UdayanSinha/Home_Automation_System/README.md

# Home_Automation_System
A prototype IoT-friendly home automation system. Built to be scalable and efficient. Some source files are missing in the repository. Feel free to contact for any doubts &amp; queries.
