UdayanSinha/Home_Automation_System/Report.pdf

# HOME AUTOMATION SYSTEM

### A Graduate Project Report submitted to Manipal University in partial fulfilment of the requirement for the award of the degree of

## BACHELOR OF TECHNOLOGY

In

## Instrumentation and Control Engineering

### Submitted by

## Udayan Prabir Sinha

## Pranay Raj Singh

### Under the guidance of

Mr. Anjan Gudigar

Assistant Professor (Sr. Scale) Department of Instrumentation and Control Engineering

DEPARTMENT OF INSTRUMENTATION AND CONTROL ENGINEERING

## MANIPAL INSTITUTE OF TECHNOLOGY

(A Constituent College of Manipal University) MANIPAL – 576104, KARNATAKA, INDIA

May 2015

DEPARTMENT OF INSTRUMENTATON AND CONTROL ENGINEERING

## MANIPAL INSTITUTE OF TECHNOLOGY

(A Constituent College of Manipal University) MANIPAL – 576 104 (KARNATAKA), INDIA

### Manipal 11th May, 2015

## CERTIFICATE

This is to certify that the project titled HOME AUTOMATON SYSTEM is a record

of the bonafide work done by UDAYAN PRABIR SINHA (Reg. No. 110921560) and

PRANAY RAJ SINGH (Reg. No. 110921278) submitted in partial fulfilment of the

requirements for the award of the Degree of Bachelor of Technology (B.Tech) in

INSTRUMENTATION AND CONTROL ENGINEERING of Manipal Institute of

Technology Manipal, Karnataka, (A Constituent College of Manipal University), during

the academic year 2014-15.

Mr. Anjan Gudigar

### Assistant Prof. (Sr. Scale), I & CE M.I.T, MANIPAL

Prof. Dr. Dayananda Nayak
HOD, I & CE.

### M.I.T, MANIPAL

## ACKNOWLEDGMENT

We would like to take this opportunity to thank everyone who directly/indirectly helped us with this project.

We owe our deepest gratitude to my guide, Mr. Anjan Gudigar (Assistant Professor, Sr. Scale) whose encouragement, guidance, expertise and support from the start to the finish enabled us to develop an understanding of the field and finally implement this project.

We are indebted to many of our classmates to support us all the way with the project. We would like to show our gratitude to all the lab assistants and faculty members of the Department of Instrumentation & Control Engineering for providing their valuable experience in our time of need.

Lastly, we offer our regards and blessings to all of those who supported us in any respect during the completion of the project.

## ABSTRACT

The IoT (Internet of Things) is the interconnection of uniquely identifiable embedded computing devices within the existing Internet infrastructure. With major technology giants touting IoT as the next technological revolution in embedded computing, it must be realized that an efficient and reliable home automation system will serve as the backbone of the IoT-enabled world in the consumer domain.

A prototype of a basic and functional home automation system which supports IoT integration is designed and implemented. Due to the modular nature of the design, the whole system was easily divided into small modules, each of which could be designed, tested and debugged independently before integrating them into one complete, fully-functional system. The system was divided broadly in 4 parts as explained in chapter-3: Design of the MCU-based modules, design of the remote controller, design of the central module and final integration and test-run.

A number of glitches/bugs/shortcomings related to power consumption, faulty functionality and some inherent shortcomings of the platform being used for implementation were observed in action during the final integration and testing. The reasons for the occurrence of those glitches and the corrective measures taken for rectifying them have been described.

In the end, a functional home automation system is successfully designed and implemented. Various areas of future improvement in the design are pointed out in chapter-5. A variety of hardware components (PIC18F4550 MCU, Arduino, Raspberry Pi, nRF24L01+ 2.4GHz RF communications module) and software packages (MPLAB-X IDE for PIC MCUs, Python & associated libraries, Arduino IDE, EAGLE for creating schematics, Lucid Chart for creating flowcharts) were used to design the system and the supporting documentation.

## LIST OF TABLES

Table No | Table Title | Page No
3.1 | Operating modes of an nRF24L01+ module | 8

## LIST OF FIGURES

Figure No | Figure Title | Page No
3.1 | Block diagram of the system | 5
3.2 | PIC18F4550 pin diagram | 6
3.3 | nRF24L01+ module | 7
3.4 | Pin diagram of an nRF24L01+ module | 7
3.5 | Radio control state diagram of nRF24L01+ module | 8
3.6 | Block diagram of the relay module | 9
3.7 | Flowchart of the relay module program | 10
3.8 | Circuit schematic of the relay module | 11
3.9 | Hitachi HD44780 controlled 16x2 alphanumeric LCD module pin diagram | 12
3.10 | LM35 temperature sensor pin diagram | 12
3.11 | Flowchart of the display module program | 13
3.12 | Circuit schematic of the display module | 14
3.13 | Flowchart of the password authentication sub-program | 16
3.14 | Flowchart of the password change control sub-program | 17
3.15 | Circuit schematic of the door control module | 18
3.16 | Raspberry Pi Model B+ | 19
3.17 | Arduino Uno | 20
3.18 | Flow of data on the central module | 20
3.19 | Flowchart of the central module program | 21
3.20 | Arduino Mega 2560 | 22
3.21 | Flow of data on the remote controller | 22
3.22 | Flowchart of the remote controller program | 23
3.23 | 7805 pin diagram | 24
3.24 | AMS1117 LDO voltage regulator | 24

## CONTENTS

| Page No
Acknowledgement | | i
Abstract | | ii
List Of Figures | | iii
List Of Tables | | vi
Chapter 1 | INTRODUCTION | 1
| 1.1 | Need For The Project | 1
| 1.2 | Objective | 2
| 1.3 | Project Schedule | 2
| 1.4 | Organization Of Report | 2
Chapter 2 | BACKGROUND THEORY | 3
Chapter 3 | METHODOLOGY | 4
| 3.1 | Design Of The Microcontroller (MCU) Based Modules | 5
| | 3.1.1 | Wireless Module Interfacing | 6
| | 3.1.2 | Relay Module | 9
| | 3.1.3 | Display Module | 12
| | 3.1.4 | Keypad-Based Door Control Module | 15
| 3.2 | Design Of The Central Module | | 19
| 3.3 | Design Of The Remote Controller | | 22
| 3.4 | Power Supply Design | | 24
Chapter 4 | RESULT ANALYSIS | 25
Chapter 5 | CONCLUSION AND FUTURE SCOPE OF WORK | 26
REFERENCES | 27
ANNEXURE | 28
PROJECT DETAILS | 38

1

### CHAPTER 1 INTRODUCTION

The IoT (Internet of Things) is the interconnection of uniquely identifiable embedded computing devices within the existing Internet infrastructure. Typically IoT is expected to offer advanced connectivity of devices, systems and services that go beyond standard M2M (machine-to-machine) communications [1]. It is expected to usher in automation in nearly all fields and allow for advanced applications like Smart Grid [1]. A home automation system has been envisioned to be the central hub of IoT-enabled devices in the consumer domain. Hence, it is necessary that a reliable, efficient and smart home automation system be designed to allow for easy integration of such devices.

### 1.1 NEED FOR THE PROJECT

With major technology giants touting IoT as the next technological revolution in embedded computing, it must be realized that an efficient and reliable home automation system will serve as the backbone of the IoT-enabled world in the consumer domain [1]. A home automation system in an IoT-enabled world will be connected to for example:

- Medical devices such as blood glucose monitors and pace makers which would send regular reports to the doctor via the Internet connection of the home automation system. This will allow for potentially early diagnosis of diseases and better health monitoring [3].
- Automobiles, the on-board car computer will monitor data from various sensors & alert the end-user in situations like when maintenance is required or tire pressure is low or it needs to be refueled.
- Home security systems to automatically alert the emergency services in situations like fire, break-in, etc. [2].
- IoT-enabled home appliances; for example a coffee-maker which automatically brews up coffee for the end-user in the morning when he wakes up & in the evening when he is about to return from work or a smart refrigerator which uses computer vision to monitor food health & alert the user of rotting food [2].
- Wearable computers like smart watches.
- Smart energy meters to intelligently regulate power to the house & ensure that monthly power consumption does not cross a fixed threshold [2].

2

The nature of IoT warrants a modular and (depending on the application) possibly decentralized design of the system.

### 1.2 OBJECTIVE

To design and implement a basic and functional home automation system which allows easy integration of IoT-enabled devices.

### 1.3 PROJECT SCHEDULE

- January 2015
- Design of the system and finalization of its specifications.
- Selection of components.
- February 2015
- Design of microcontroller based modules.
- March 2015
- Design of the remote controller.
- Design of the central module.
- April 2015
- Integration of the module into 1 complete system.
- Complete system test-run and optimization.
- May 2015
- Documentation.

### 1.4 ORGANIZATION OF REPORT

- Chapter 1: Brief introduction of the project and motivation. Project objectives and schedule are also included
- Chapter 2: Survey of relevant literature and conclusions drawn from it.
- Chapter 3: Project methodology, program flowcharts and working
- Chapter 4: Result analysis. Analysis of shortcomings detected and corrective measures taken.
- Chapter 5: Future scope of the project discussed.

3

### CHAPTER 2 BACKGROUND THEORY

Mentioned below are some of the relevant literature which that were reviewed and the topics which were found to be relevant to the project in that literature:

- Richard Harper [2], talks about the predictions of leading electronics and consumer companies such as, in the future we may never again have to worry about forgetting to switch the lights off, or locking the front door when we leave our home. Even mundane chores such as visiting the local supermarket to stock up your fridge will become a thing of the past, as the Smart Homes of the future will be able to decide what is needed and order them for us. This book looks at the designs and technologies behind these new innovations, along with their time-saving, environmental and security benefits, amongst others. Despite these clear advantages however, Smart Homes have so far failed to reach the levels of success originally anticipated, thereby forcing designers to further examine the roles and practicalities of these new technologies. Through the use of detailed case studies from such international giants as Orange, Ariston, Philips Electronics and Electrolux, this book clearly demonstrates what will be possible for our domestic settings in the future if we continue to develop the concept of the Smart Home.
- William Mann [3], talks about recent research and technological developments from engineering, computer science, and the rehabilitation sciences, detailing how its applications can promote continuing independence for older persons and those with disabilities. The author has used detailed product descriptions, photographs and illustrations, and case studies, to discuss the influence of cutting-edge technologies on wearable systems, human-computer interactions, assisted vision and hearing, smart wheelchairs, handheld devices and smart phones, visual sensors, home automation, assistive robotic sand in-room monitoring systems. The author examines recent trends in other critical areas, such as basic assistive technologies, driving, transportation and community mobility, home modifications and design, and changing standards of elder care.
- Recently, it is observed that how the Internet of Things (IoT) will deliver a smarter grid to enable more information and connectivity throughout the infrastructure and to homes [1]. The author explains how the IoT, consumers, manufacturers and utility providers will uncover new ways to manage devices and ultimately conserve resources and save money by using smart meters, home gateways, smart plugs and connected appliances. The author

4

discusses, the different approaches being taken worldwide to connect the smart grid. Examples are provided on how Texas Instruments is developing full system solutions by combining hardware (analog and digital) and software to address some of the challenges in building a smarter and more connected smart grid. The author also tells us about the key defining characteristics of an IoT device and the role of a full-fledged home automation system in consumer IoT.

All of the above mentioned literature put forward some important design aspects which must be considered while designing IoT applications:

- Power efficient design.
- Modular and decentralized design.
- Networked design.
- An IoT device does not need to be connected to the Internet directly.

5

### CHAPTER 3 METHODOLOGY

The modular nature of the design allows easy division of the whole system into small modules, each of which can be designed, tested and debugged independently before integrating them into one complete, fully-functional system.

Hence, project design is carried out in the following parts:

- Design of the microcontroller based modules:
- Design of the display module (displays useful information to the user).
- Design of the relay module (use to control flow of power to appliances, lights, fans, etc.).
- Design of the door locking module (used to lock/unlock front door of the house).
- Design of the remote controller (used by the user to control the system):
- Selection of interface (preferably touch-screen) & required hardware.
- Design of software for the interface and transmit input data in a desirable format wirelessly.
- Design of the central module:
- Implement program to fetch weather & time data using an appropriate developer API.
- Use available libraries to process the data and transmit it in desirable format wirelessly.
- Final integration and testing:
- Optimize and integrate the modules into a complete and functional home automation system.

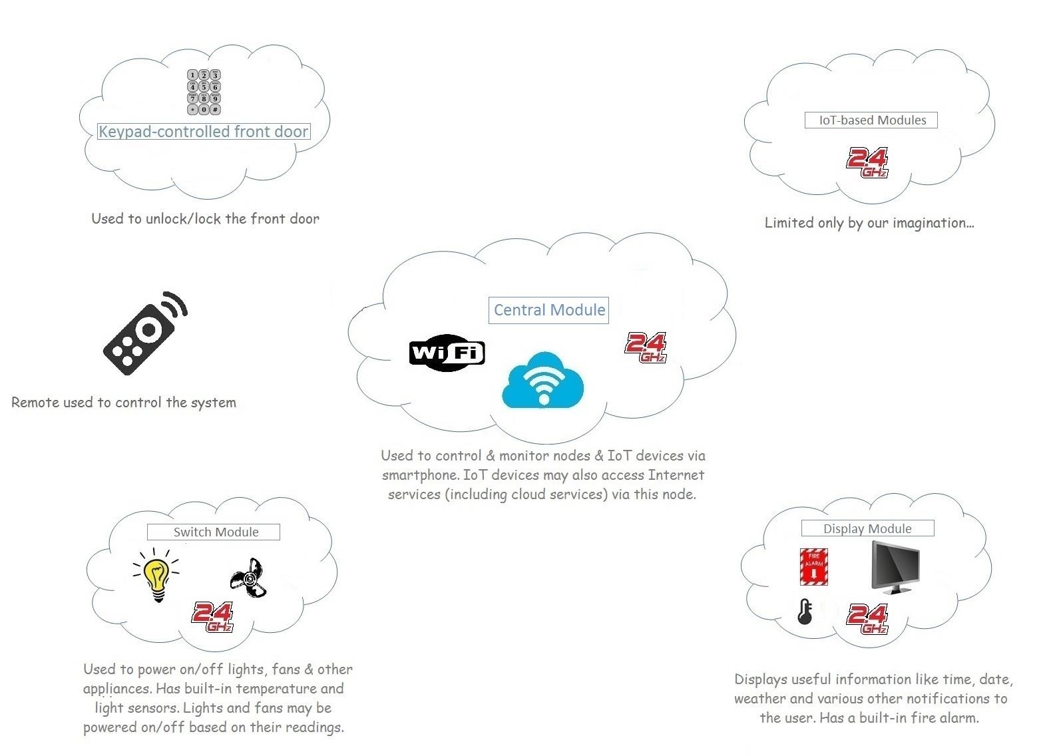
[picture p1: figure]

6

Fig. 3.1 Block diagram of the system

### 3.1 DESIGN OF THE MICROCONTROLLER (MCU) BASED MODULES

All MCU-based modules have been implemented using the PIC18F4550. The PIC18 family of MCUs were selected due to the following reasons:

- Extremely reliable architecture.
- User-friendly IDE (Integrated Development Environment) and professional-grade C-compiler.
- Excellent documentation and programming tools.
- Easily available at lower price (compared to rival manufacturers).
- The rich set of features and peripherals on-board the PIC18F4550 allows plenty of room for further functionality improvement and enhancement.

7

Specifications of the PIC18F4550:

- 8-bit MCU.
- 32kB flash memory.
- 2kB RAM.
- 256 bytes EEPROM.
- Available in a 40 pin DIP (Dual-inline package).
- 12MIPS maximum throughput.

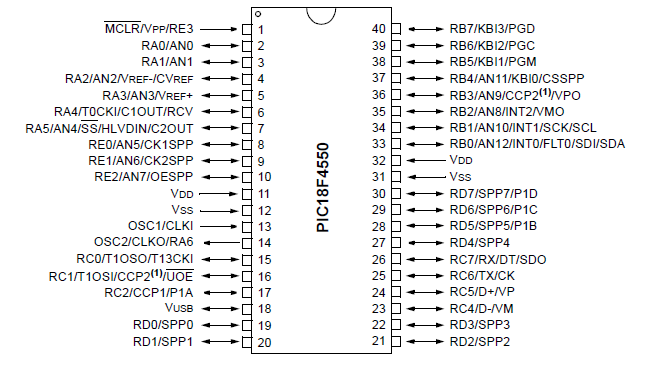
[picture p2: figure]

Fig. 3.2 PIC18F4550 pin diagram

### 3.1.1. Wireless Module Interfacing

While Zigbee is a good choice for this application, it was too expensive. It was decided to use the low cost nRF24L01+ 2.4GHz RF transceivers by Nordic Semiconductors. nRF24L01+ has been specifically designed for power efficient IoT-based applications which require efficient and reliable communication and can be easily interfaced to an MCU.

Basic specifications of the nRF24L01+:

- Communication at 2.4GHz with air data rates of up to 2Mbps.
- SPI interface.
- Maximum data payload of 32 bytes.
- 3.3V logic (5V-tolerant I/O pins).

8

- Interrupt on packet reception and transmission.
- Guaranteed 30m line-of-sight range at 2Mbps air data rate.

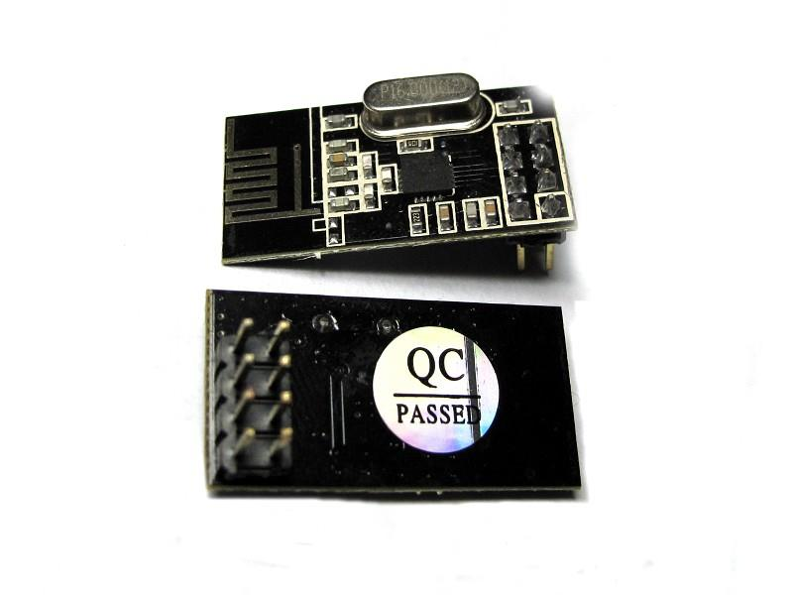
[picture p3: figure]

Fig. 3.3 nRF24L01+ module

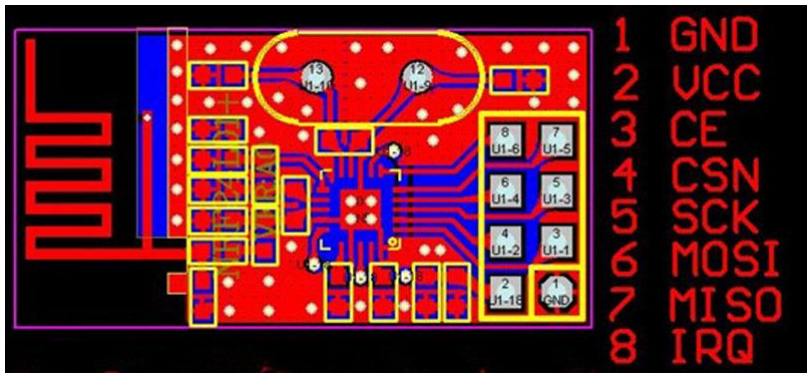
[picture p4: figure]

Fig. 3.4 Pin diagram of an nRF24L01+ module

With plenty of documentation and tutorials available for it, it was easy to get an Arduino and a PIC MCU communicating with each other wirelessly in the tests. In the project, the data rate has been set to 250kbps (slowest) and the payload length to 8 bytes. The SPI bus speed is limited to 312.5 kbps. The module can only transmit or receive data at any given instant (half-duplex communication).

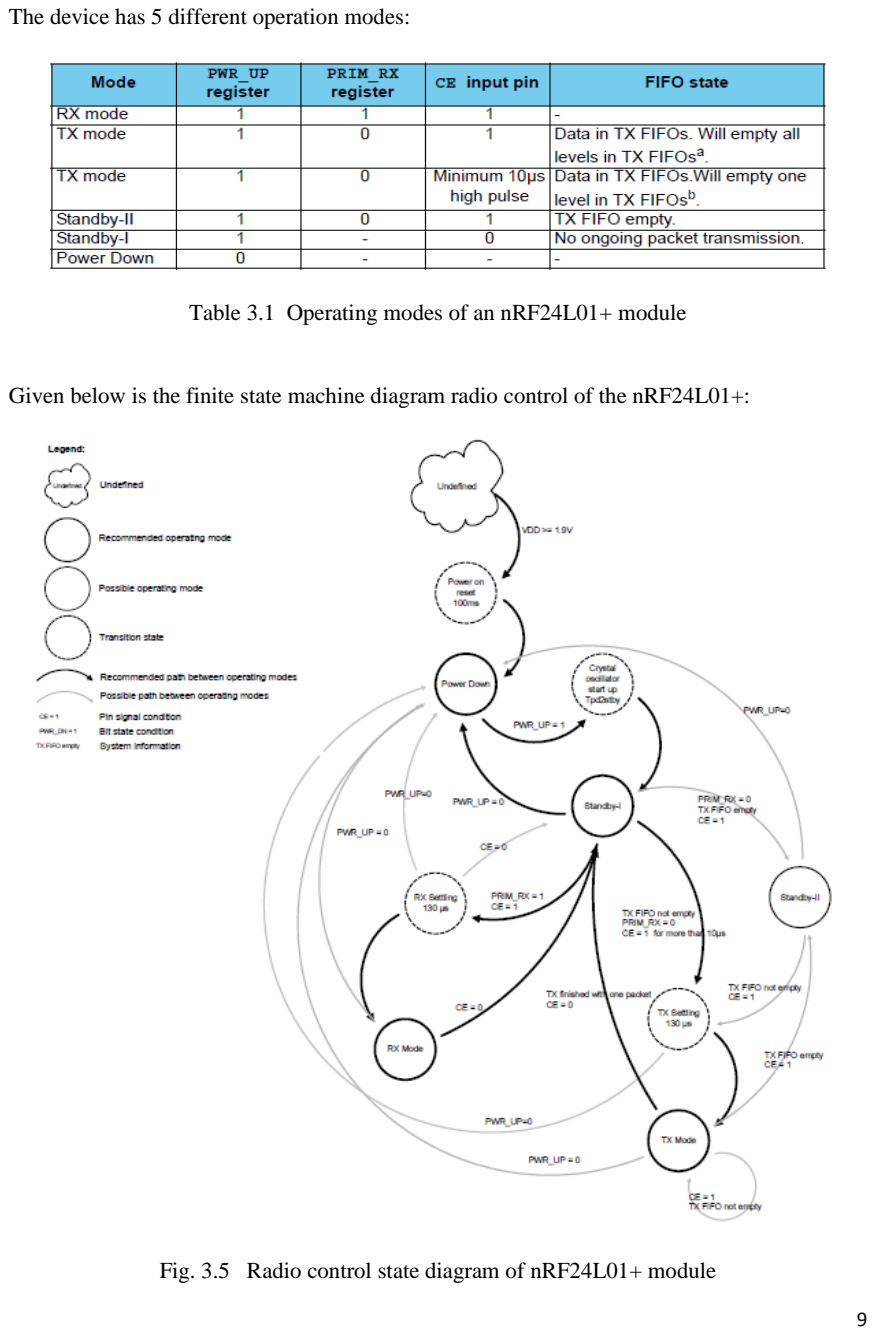
[picture p5: page 16]

9

The device has 5 different operation modes:

Table 3.1 Operating modes of an nRF24L01+ module

Given below is the finite state machine diagram radio control of the nRF24L01+:

Fig. 3.5 Radio control state diagram of nRF24L01+ module

10

### 3.1.2 Relay Module

Relay module is implemented using a PIC18F4550. Testing involved sending control codes via the remote controller and checking for the correct response from the module. All communication took place wirelessly via the nRF24L01+.

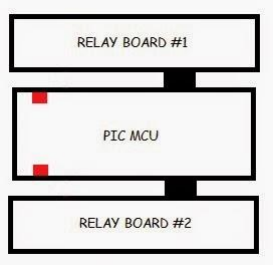
[picture p6: figure]

Fig. 3.6 Block diagram of the relay module

- There are 8 relays on each board (16 relays in total). The end-user may choose to buy 1 or both boards for use in the system. Off-the-shelf relay boards will be used in the design.
- The black connections between the PIC MCU and the relay boards represent control lines for energizing/de-energizing the relays.
- The red dot on the PIC MCU board represents enable lines for each of the board. This is a safety feature.
- Whenever a relay board is connected, the enable line for it is activated. This is detected by the PIC MCU. The ports controlling that relay board can only be used when the enable line is activated.

11

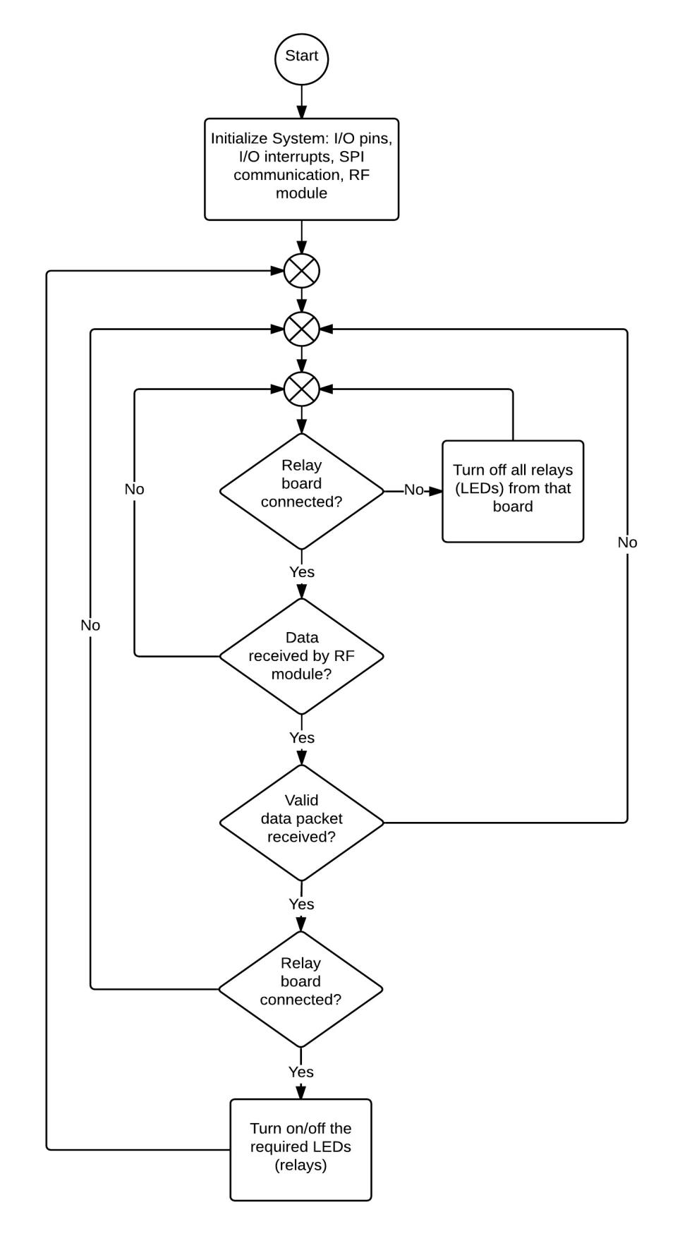
[picture p7: figure]

Fig. 3.7 Flowchart of the relay module program

12

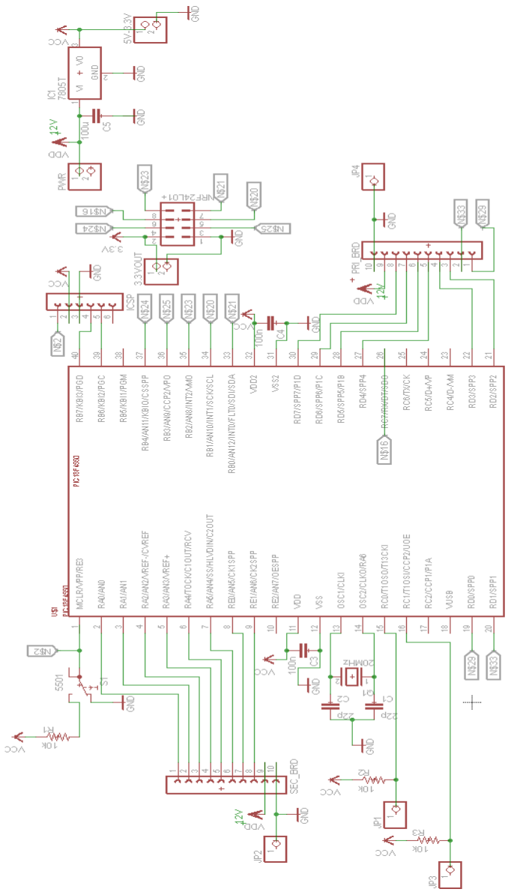
[picture p8: figure]

Fig. 3.8 Circuit schematic of the relay module

13

### 3.1.3 Display Module

The display module has been implemented using the PIC18F4550. There are 2 types of messages which this module will be receiving wirelessly via the nRF24L01+:

- Weather data
- Time & date data

The module toggles between displaying time-date and weather every 10 seconds. This information is displayed on a standard Hitachi HD44780-controlled 16x2 alphanumeric LCD. This LCD is widely used in embedded system projects and hence, it was easy to interface it with the PIC MCU.

An LM35 temperature sensor is also used for sensing the room temperature. An indicator LED (alarm) will light up to indicate the possibility of fire if the temperature exceeds 55°C. Just like the LCD, LM35 is a widely used temperature sensor in embedded system projects and it was easy to interface it with the PIC MCU. It is factory-calibrated directly in °C (10mV/°C linear sensitivity) and can be used to sense temperature ranging from -55°C to 150°C.

Hence there are 2 parts to the program (both running simultaneously):

- Display management: Toggles between displaying time-date and weather.
- Wireless communication: Receives data and sorts it systematically for displaying.

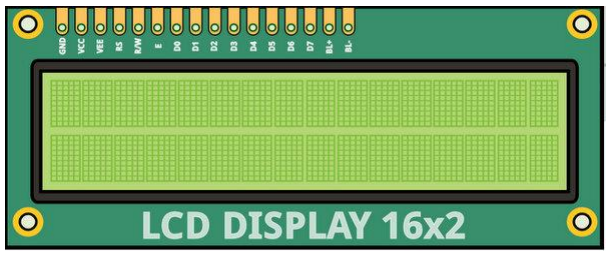
[picture p9: figure]

Fig. 3.9 Hitachi HD44780 controlled 16x2 alphanumeric LCD module pin diagram

Fig. 3.10 LM35 temperature sensor pin diagram

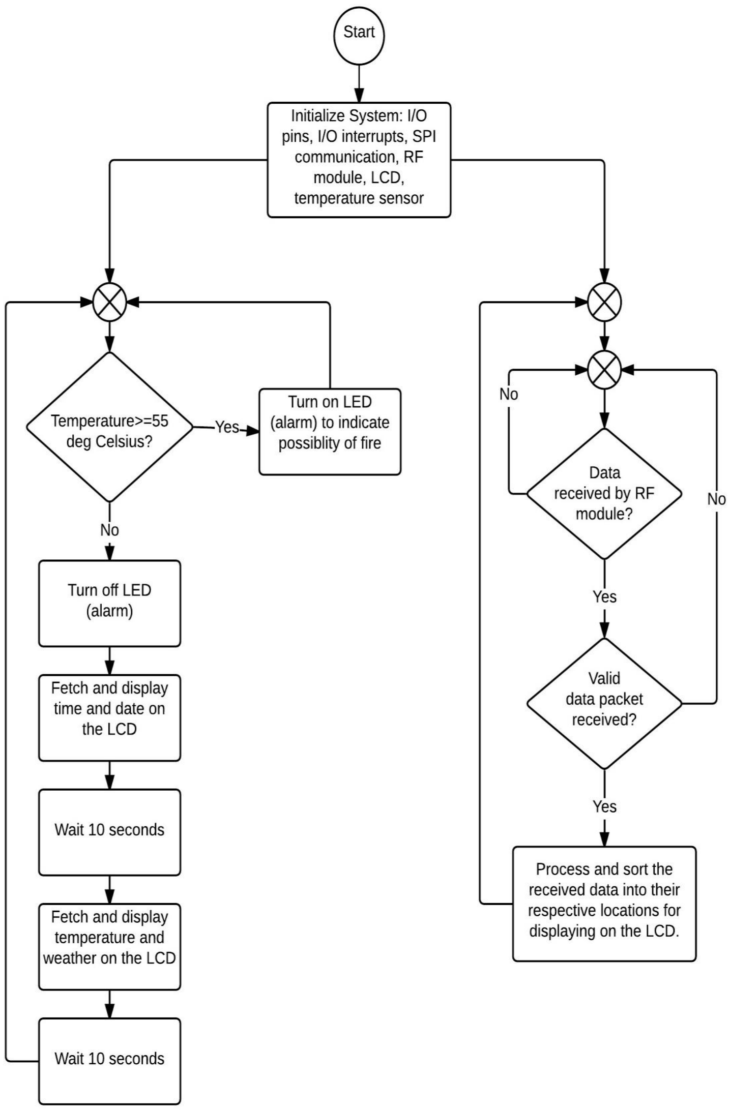
[picture p10: figure]

14

Fig. 3.11 Flowchart of the display module program

15

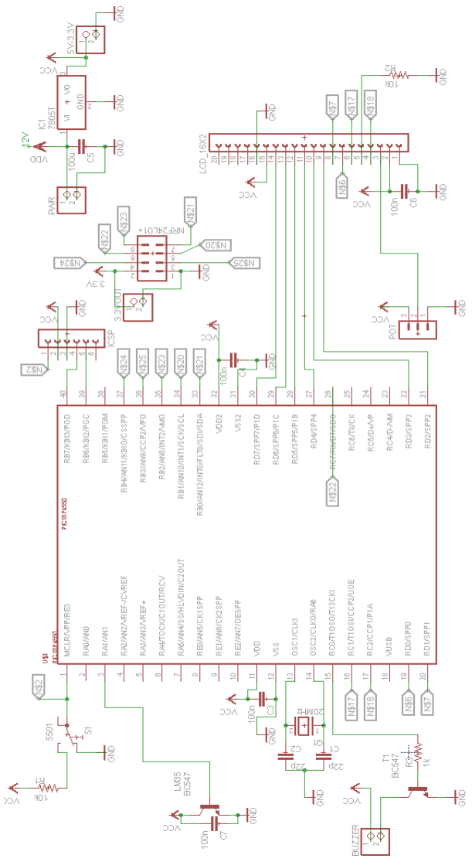
[picture p11: figure]

Fig. 3.12 Circuit schematic of the display module

16

### 3.1.4 Keypad-Based Door Control Module

The door control module has been implemented using a PIC18F4550. This will be the only module in the project which does not have a wireless module (nRF24L01+) attached to it. A standard Hitachi HD44780-controlled 16x2 alphanumeric LCD is used to display messages to and interact with the user. This LCD is widely used in embedded system projects and hence, it was easy to interface it with the PIC MCU.

A standard 4x4 matrix keypad is used to enter the password.

Features of this module:

- Standard Hitachi HD44780 controlled 16x2 alphanumeric LCD displays useful messages to the user.
- 4x4 keypad used to enter passwords.
- A yellow LED used to indicate key press.
- A green LED used to indicate that the door lock actuator is energized.
- Pushbutton used to start/stop password change procedure.
- Password is stored in the internal EEPROM of the PIC MCU.

When a correct password is entered, the actuator is energized for 5 seconds. The user must open the door in this time or he/she would have to enter the password again. Password length has been set to 4 digits (can be easily set to any value up to 256 digits).

For changing the password, the password-change button is pressed. Standard 3-step password-changing procedure is used to change the password:

- Entry of old password
- Entry of new password
- Confirmation of new password

The user can choose to quit the password-changing procedure by pressing the password-change button at any point of time in between if he decides against changing the password.

Hence there are 2 parts to the program, both running simultaneously on the MCU:

- Password authentication: Used for door access control.
- Password change control: Used to change the password used for door access control.

17

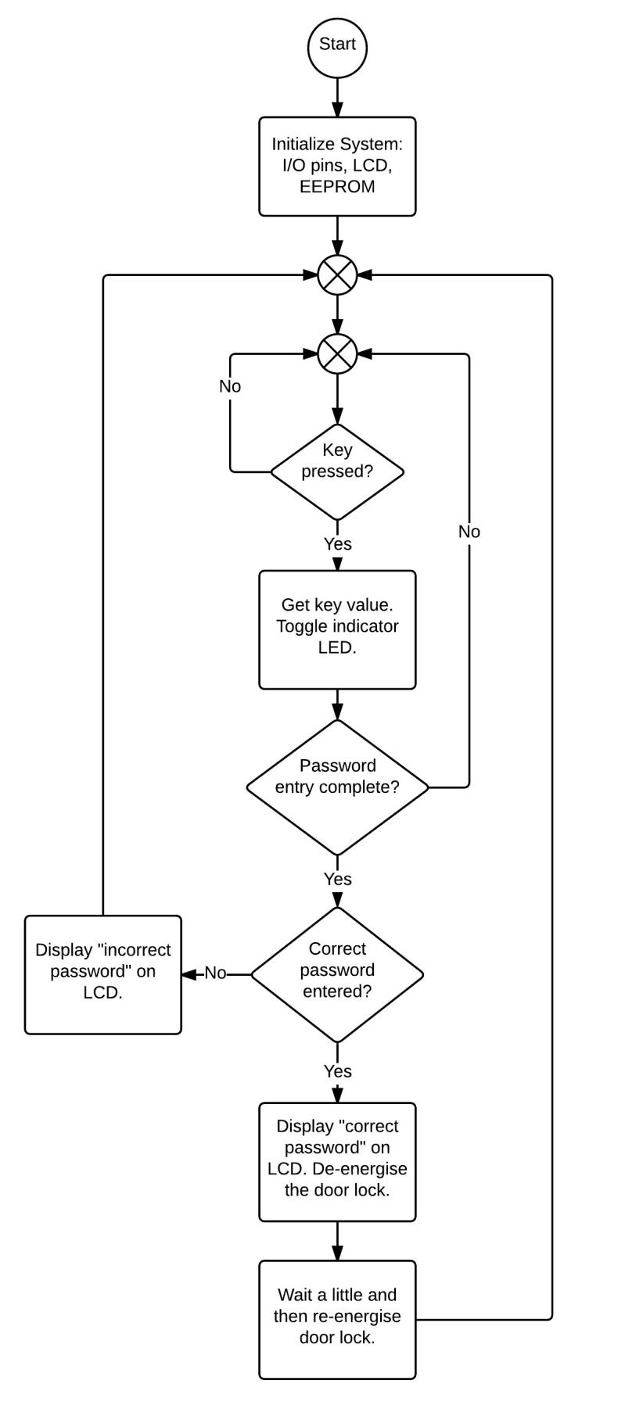
[picture p12: figure]

Fig. 3.13 Flowchart of the password authentication sub-program

18

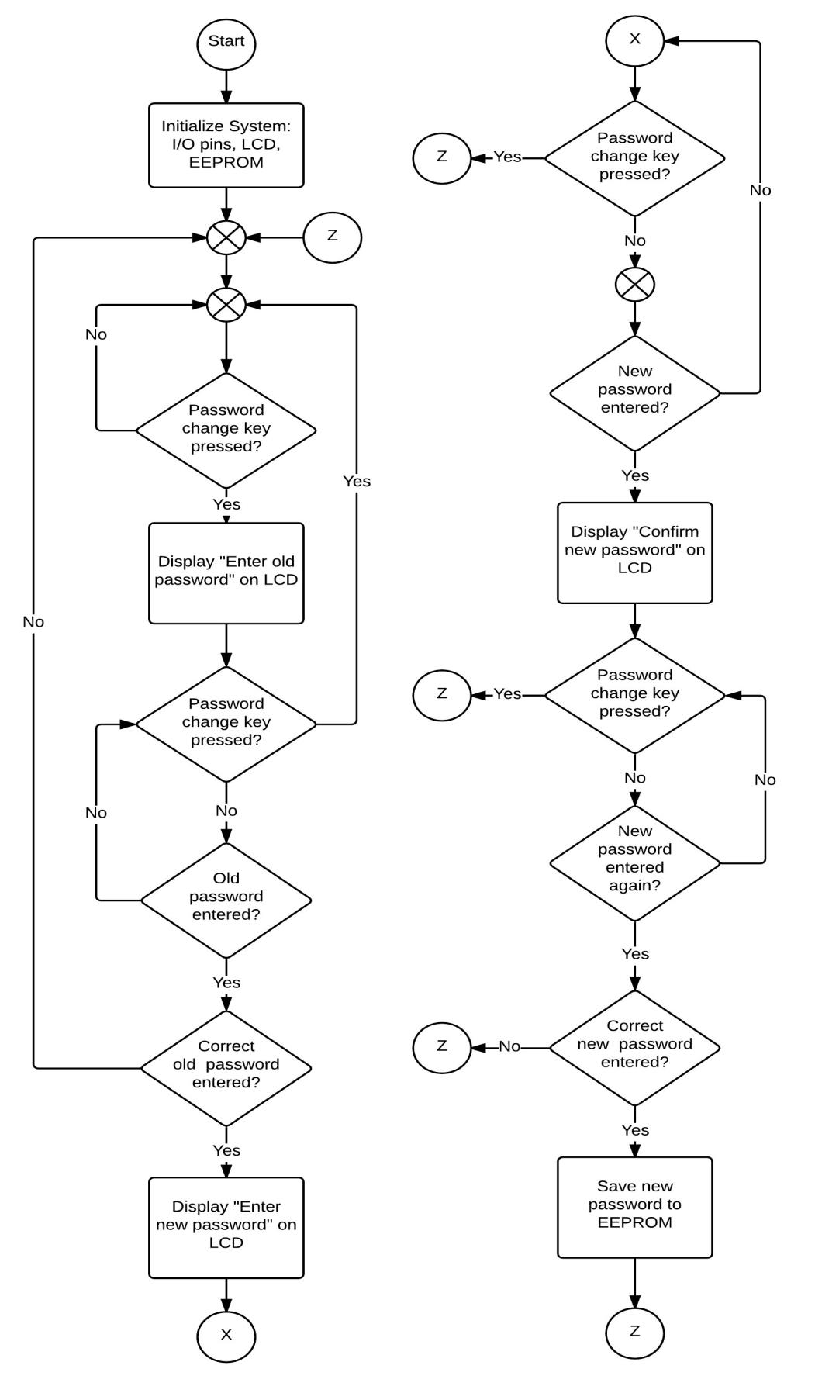
[picture p13: figure]

Fig. 3.14 Flowchart of the password change control sub-program

19

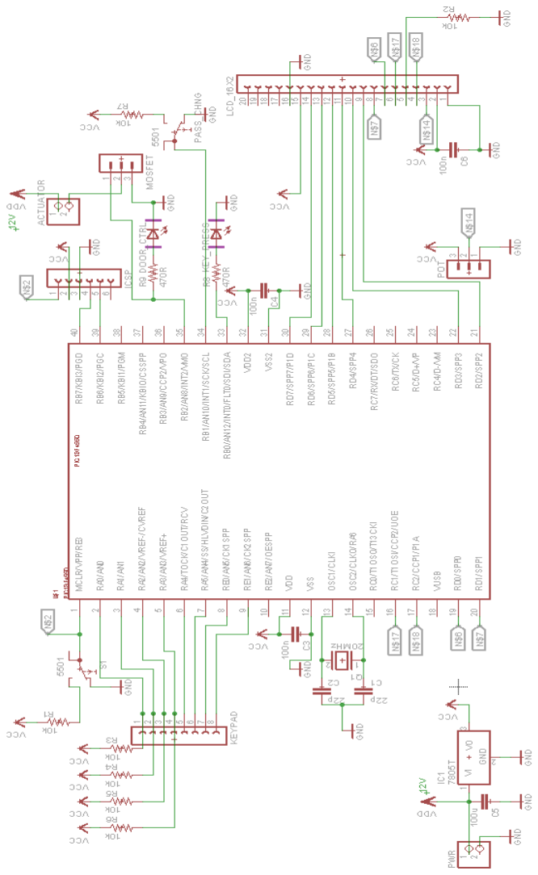
[picture p14: figure]

Fig. 3.15 Circuit schematic of the door control module

20

### 3.2 DESIGN OF THE CENTRAL MODULE

The central module is being implemented using a Raspberry Pi B+ single-board computer (SBC) and an Arduino Uno.

Key specifications of the Raspberry Pi B+:

- Broadcom BCM2835 SoC
- 700MHz ARM11 CPU
- 512MB RAM
- 4 USB 2.0 ports, 1 RJ45 Ethernet port, 1 HDMI port, 1 3.5mm audio jack
- 20x2 pin header

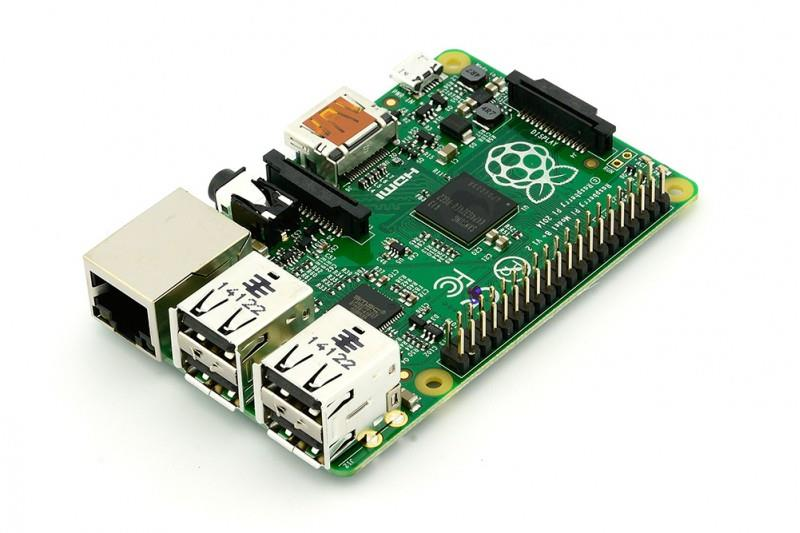
[picture p15: figure]

Fig. 3.16 Raspberry Pi Model B+

The Raspberry Pi is a widely used versatile and powerful Linux-based SBC with extensive documentation and community support. Since Raspbian (the default Linux “distro” for the Raspberry Pi) is Debian Wheezy-based, most of the standard Linux libraries can be used out-of-the-box without any modifications. Use of Python for programming is an additional advantage due to its ease of use.

21

Key specifications of the Arduino Uno:

- ATmega328 8-bit MCU.
- 32kB flash memory.
- 2kB RAM.
- 1kB EEPROM
- Available in a 28-pin DIP.
- 16MIPS maximum throughput.

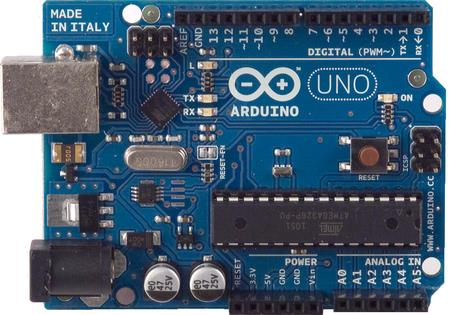
[picture p16: figure]

Fig. 3.17 Arduino Uno

The Arduino Uno is another widely used versatile and powerful open-source MCU development board with extensive community support and documentation.

Weather data is fetched through standard developer APIs from Weather Underground. The data is received in JavaScript format, which is then processed by the Raspberry Pi using standard Python libraries into a structured dictionary for easy access. Date and time are fetched and processed using standard Python libraries as well.

These are sent to the Arduino Uno via UART (Universal Asynchronous Receiver Transmitter). The Arduino then transmits this information wirelessly via nRF24L01+.

Fig. 3.18 Flow of data on the central module

22

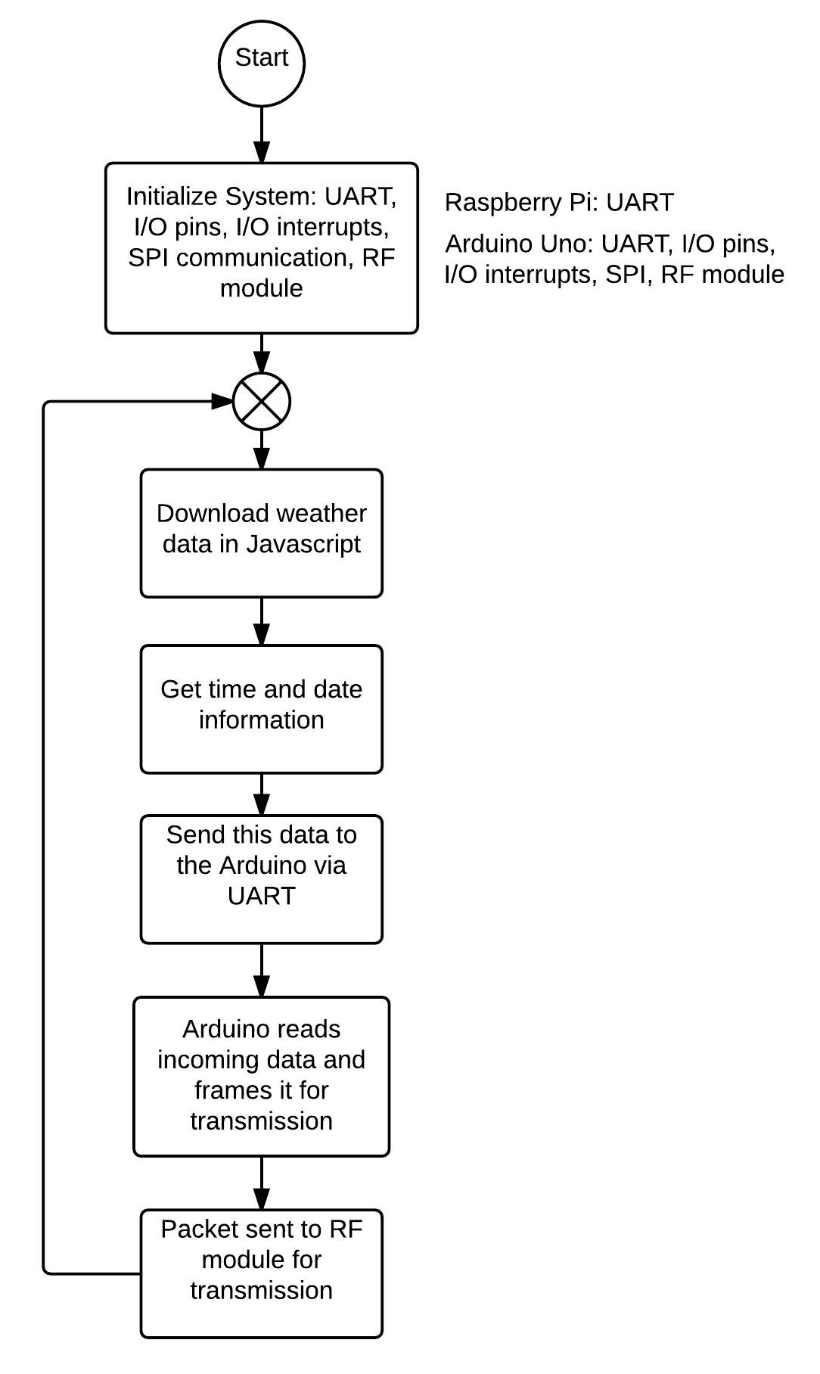
[picture p17: figure]

Fig. 3.19 Flowchart of the central module program

23

### 3.3 DESIGN OF THE REMOTE CONTROLLER

The central module is being implemented using a Raspberry Pi B+ single-board computer (SBC) and an Arduino Mega 2560. An Arduino and a Raspberry Pi was chosen again here mainly due to the large community support and extensive documentation for each of the platforms and their flexibility.

Key specifications of the Arduino Mega 2560:

- ATmega 2560 8-bit MCU.
- 256kB flash memory.
- 8kB RAM.
- 4kB EEPROM
- 54 GPIO (general purpose I/O) pins
- 16MIPS maximum throughput.

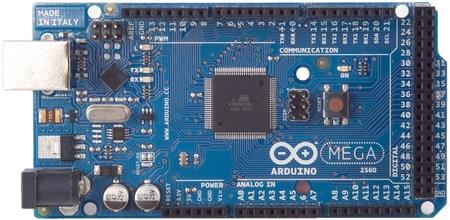
[picture p18: figure]

Fig. 3.20 Arduino Mega 2560

A standard Python GUI developer framework known as TKinter to develop the GUI in Python. The GUI has been designed to be simple as well as maintain functionality and reliability. The GUI has been designed for controlling 1 relay boards for now. It can easily be expanded for controlling more boards if necessary. The GUI is intended for touch-based controllers but can be used through a simple mouse-keyboard interface too.

This Python-based GUI accepts inputs from the user and controls a number of I/O pins accordingly. The Arduino Mega 2560 reads the state of these I/O pins and accordingly sends control signals to the relay module.

Fig. 3.21 Flow of data on the remote controller

24

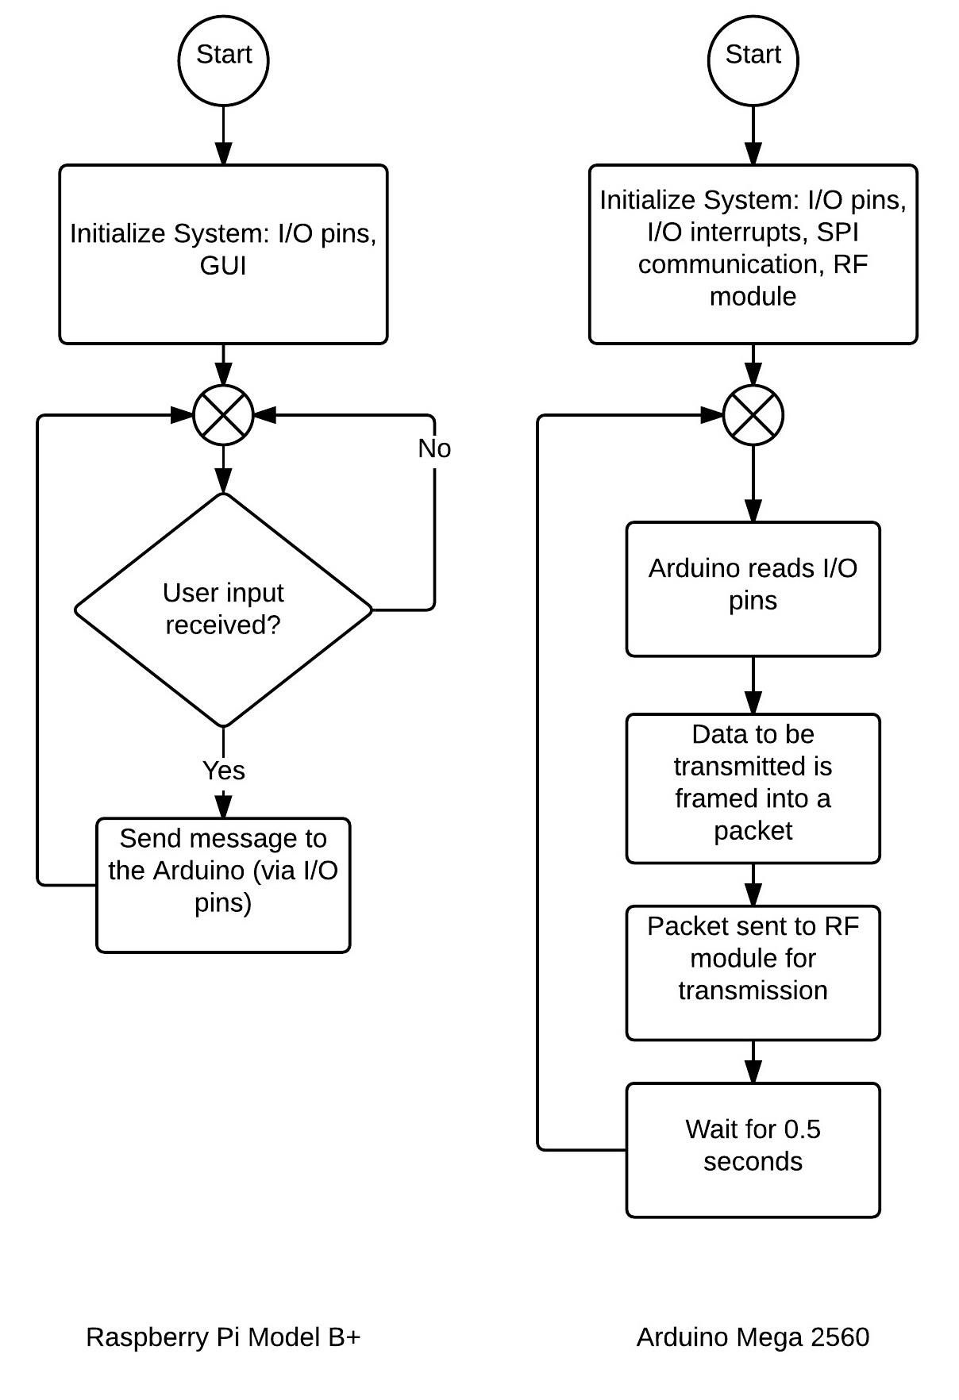
[picture p19: figure]

Fig. 3.22 Flowchart of the remote controller program

25

### 3.4 POWER SUPPLY DESIGN

The system requires 2 separate power rails for operation:

- 5V
- 3.3V (only for the nRF24L01+)

The 5V power rail for the MCU-based modules was designed using a 7805 positive voltage regulator. It is a widely used voltage regulator with maximum output current of up to 500mA (without heat sink) and up to 1A (with heat sink), more than enough to ensure smooth operation of the system.

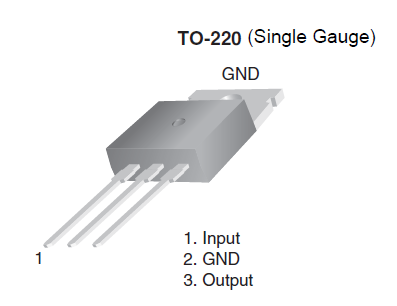
[picture p20: figure]

Fig. 3.23 7805 pin diagram

The 3.3V power rail for the MCU-based modules was designed using an AMS1117 LDO (low drop-out) voltage regulator. 5V output from the 7805 is fed into the AMS1117 to create the 3.3V rail for the nRF24L01+. It can provide output current of up to 1A. Since the IC is available only in SMD (surface-mount device) packages, a breakout PCB was used for implementation as shown below.

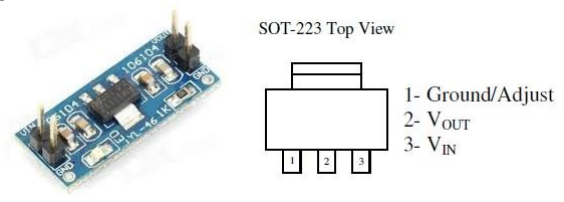
[picture p21: figure]

Fig. 3.24 AMS1117 LDO voltage regulator

The remote controller and the central modules already have 5V and 3.3V power rails built into them.

26

### CHAPTER 4 RESULT ANALYSIS

With all the modules independently designed and tested successfully, they were finally integrated into 1 complete system. The following glitches/bugs/shortcomings where noticed during the final integration and testing:

- A glitch was noticed in the relay module which caused the relays to automatically switch on/off erratically. This was caused due to the program continuously scanning and updates the I/O pin states. This was corrected to only scan/update the I/O pins when it receives a new data packet through the nRF24L01+.
- An additional shortcoming discovered in the prototype was the high consumption of power by the modules (IoT-based applications should be power efficient) as they were fully active even when not doing any significant work. This could not be rectified at this stage without changing the program flow significantly and conducting extensive tests on the performance of the new code. This can, however be corrected in future iterations of the prototype and the features required to achieve this are already present in the processing devices (as discussed in the next chapter).
- A glitch was observed in the Arduino Uno development board which is connected to the display module. The latest revision of the Arduino Uno boot-loader has a bug which sometimes causes the MCU to “hang up” during operation. This will however be rectified in forthcoming versions of the boot-loader. A temporary fix to this problem would be to use another Arduino Mega 2560 instead of an Arduino Uno (the boot-loader for the Arduino Mega 2560 is completely stable) or flashing the ATmega328 on the Arduino Uno with a previous version of the boot-loader.

Rest assured, the system performed as expected during the tests.

27

### CHAPTER 5 CONCLUSION AND FUTURE SCOPE OF WORK

The objective was to design and implement a basic and functional home automation system which allows easy integration of IoT-enabled devices.

A modular approach was employed to design the system (described earlier in detail):

- Design of the microcontroller based modules.
- Design of the remote controller (used by the user to control the system).
- Design of the central module.
- Final integration and testing.

While a basic and functional home automation system was successfully designed, implemented and tested, there is plenty of space for future improvements in the design:

- Increasing power efficiency: Improvement in power consumption by put the modules in sleep mode and using wake-up-on-interrupt feature (available in most MCUs now). This would result in a drastic decline in power consumption. After all, power efficiency is envisioned to be a defining characteristic of most IoT-enabled devices.
- Use of smartphone based remote controllers: Carrying an extra device can tend to be cumbersome and tedious for the end-user. A smartphone-based solution on the other hand is more efficient and handy. Suitable apps can be designed for Android and iOS based devices (since these are the 2 most widely used mobile OS platforms). This would however require that all communication to and from the smartphone occur through the central module as that is the only module connected to the Internet directly (Bluetooth has limited range). Used of a smartphone will also allow easy control of any IoT-enabled devices connected to the system. A whole ecosystem of apps for control of the system and IoT-enabled devices can be created.
- Use of a more aesthetically appealing GUI on the display module: This would however increase the cost of the system as an SBC would be required to support such a GUI.
- Use of camera at the front door: To take a snapshot of the person who is entering the house. This can be used for security by alerting the user to possible break-in. Various other security measures like motion sensors can also be used at other doors and windows.

28

### REFERENCES

1. O. Monnier, A smarter grid with the Internet of Things, SLYB214, Texas Instruments, May 2014.
2. Harper, Richard, Inside the smart home, Springer, ISBN: 1852336889
3. Mann, William, Smart technology for aging, disability and independence: the state of the science, John Wiley & Sons, ISBN: 0471696943

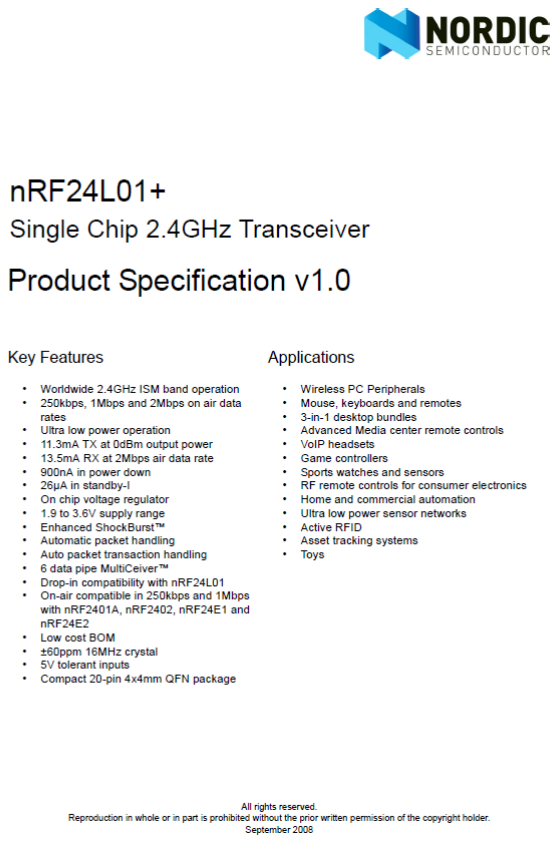
[picture p22: figure]

29

ANNEXURE

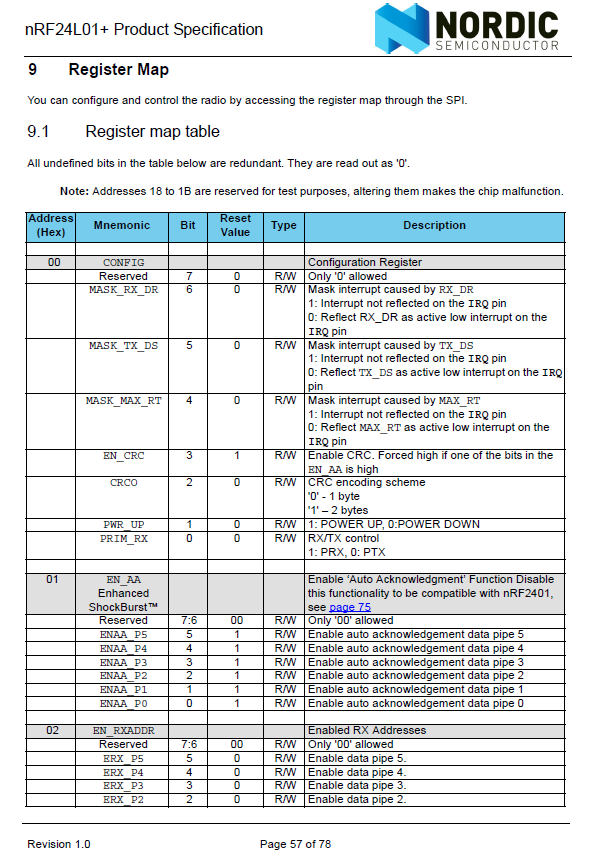
[picture p23: figure]

30

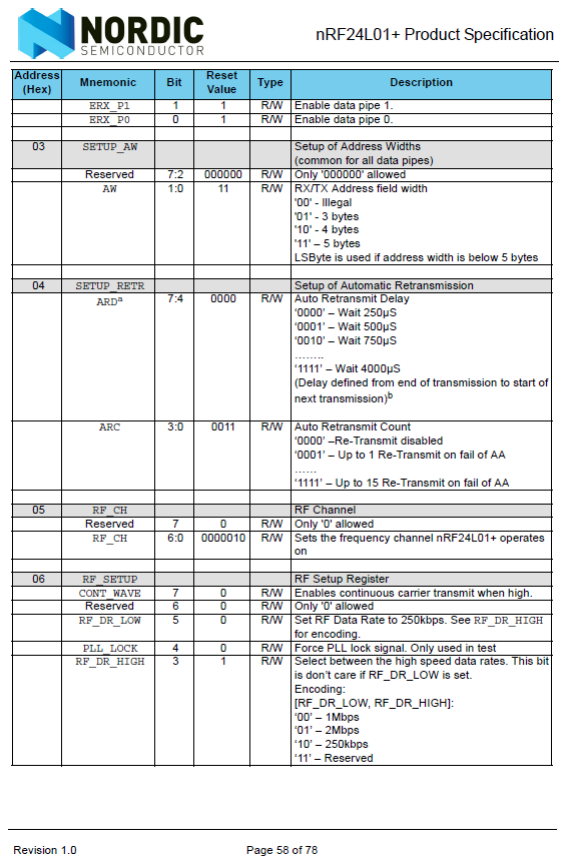
[picture p24: figure]

31

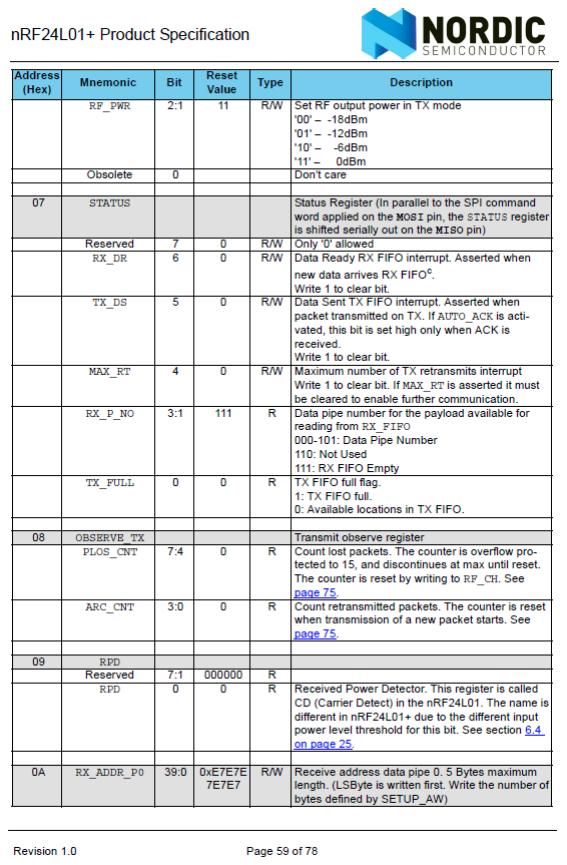
[picture p25: figure]

32

33

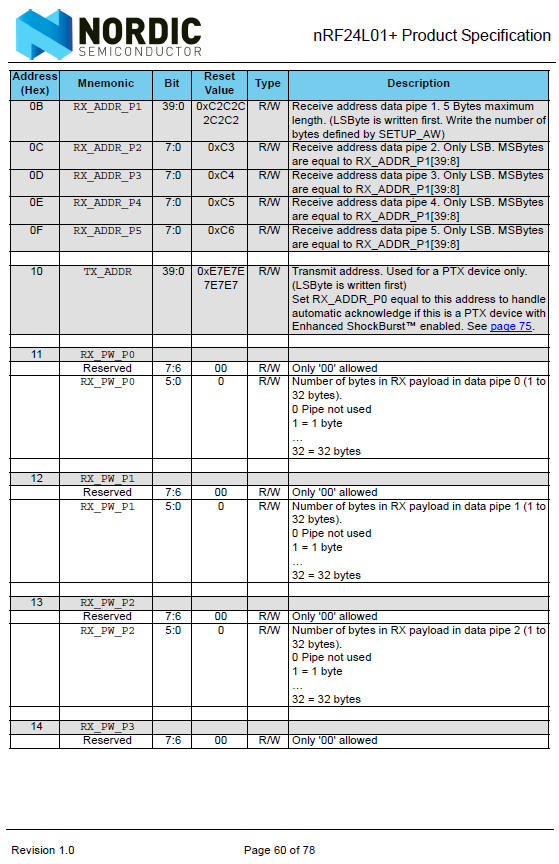
[picture p26: figure]

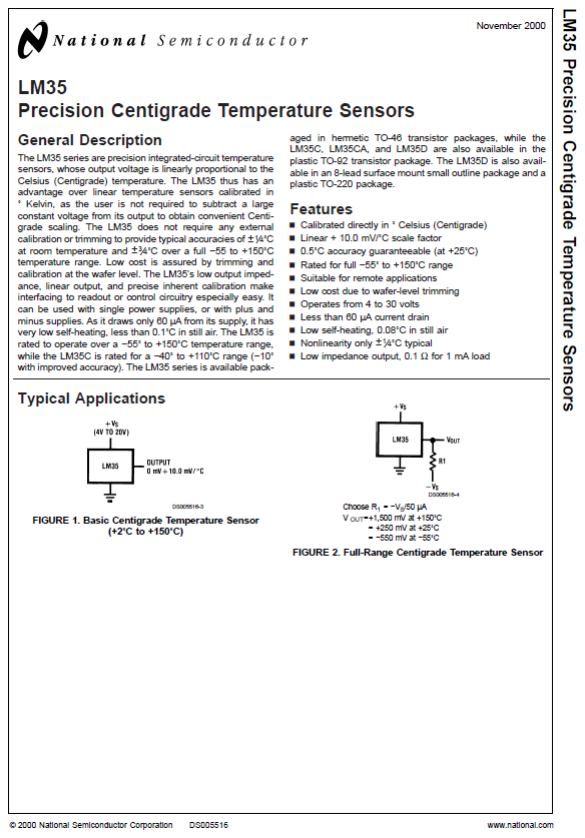
[picture p27: figure]

34

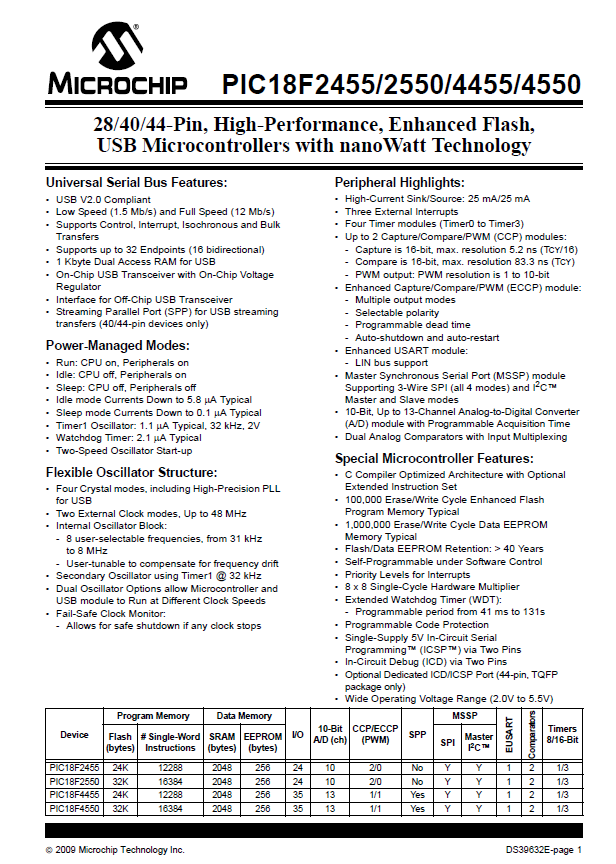
[picture p28: figure]

35

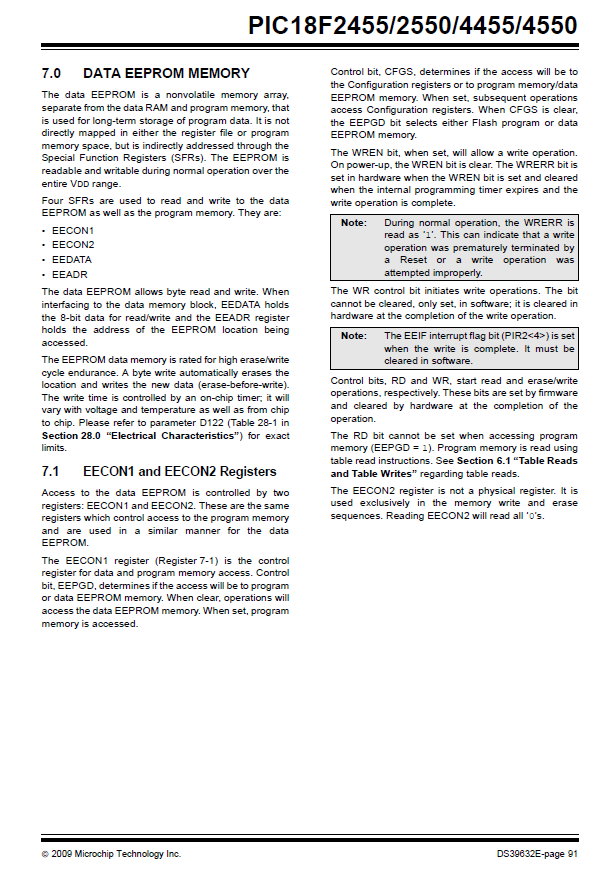
[picture p29: figure]

36

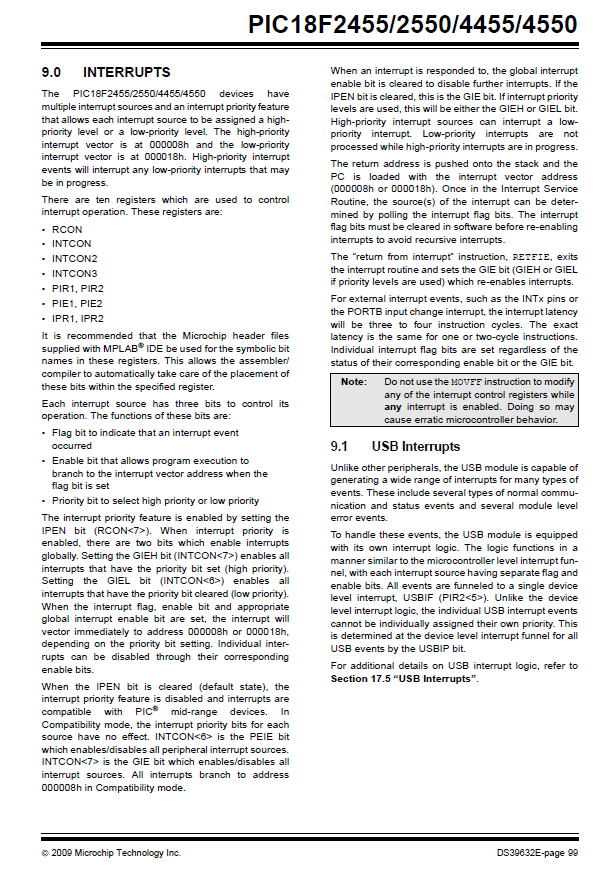
[picture p30: figure]

37

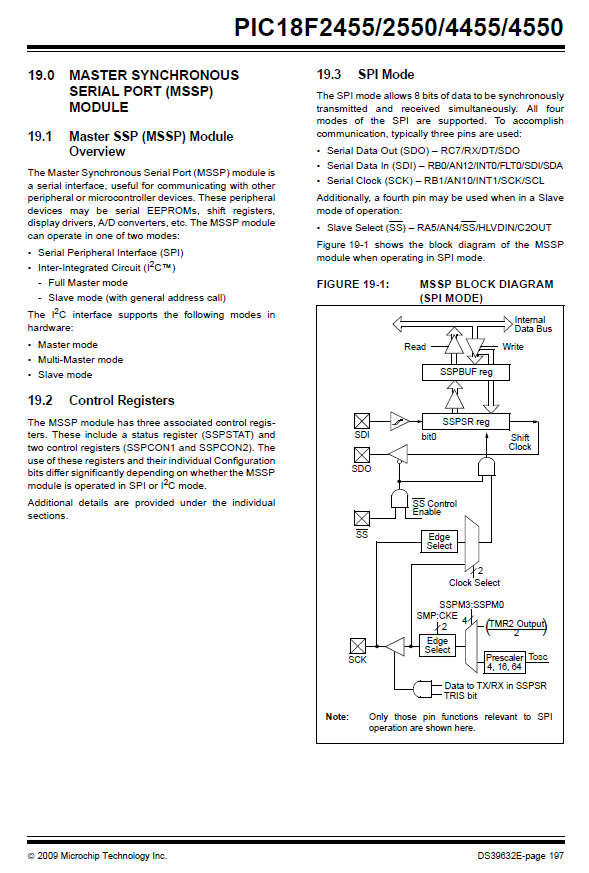
[picture p31: figure]

38

39

PROJECT DETAILS

Student Details
Student Name | UDAYAN PRABIR SINHA
Register Number | 110921560 | Section / Roll No | A/76
Email Address | udayanprabirsinha@gmail.com | Phone No (M) | 9538430294
Student Name | PRANAY RAJ SINGH
Register Number | 110921278 | Section / Roll No | A/21
Email Address | sng.pranay@gmail.com | Phone No (M) | 9008770212

Project Details
Project Title | HOME AUTOMATION SYSTEM
Project Duration | 4 months | Date of reporting | 12th January, 2015

Organization Details
Organization Name | MANIPAL INSTITUTE OF TECHNOLOGY
Full postal address with pin code | Manipal Institute of Technology, Manipal – 576104 (Karnataka State), INDIA
Website address | http://manipal.edu/mit.html

Supervisor Details
Supervisor Name
Designation
Full contact address with pin code
Email address | Phone No (M)

Internal Guide Details
Faculty Name | ANJAN GUDIGAR
Full contact address with pin code | Dept of Instrumentation and Control Engg., Manipal Institute of Technology, Manipal – 576 104 (Karnataka State), INDIA
Email address | anjan.gudigar@manipal.edu
