UdayanSinha/Home_Automation_System/Schematics/HAS_Display_Module.sch

## EAGLE design Schematics/HAS_Display_Module.sch (2016-03-23)

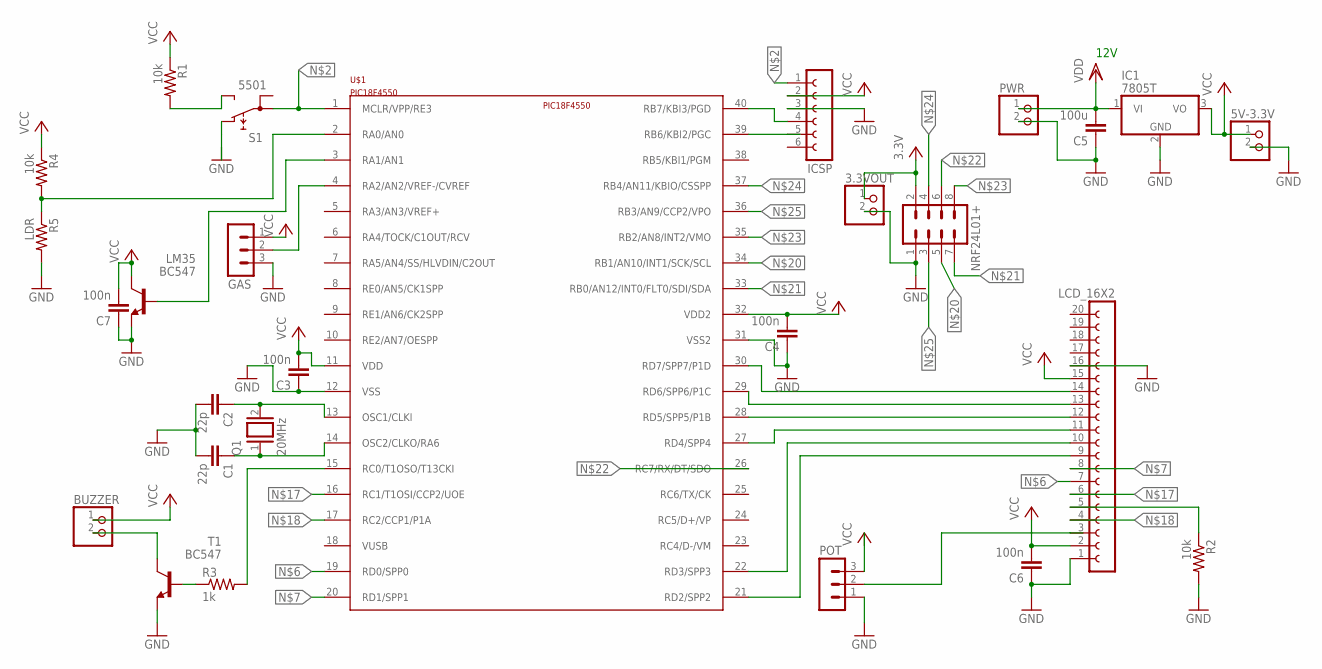
[picture p32: schematic HAS_Display_Module.sch]

Parts:
3.3VOUT, 5V-3.3V: PINHD-1X2; 1X02
BUZZER: PINHD-1X2; 1X02
C1, C2: 22p; C2.5-3
C3, C4, C6, C7: 100n; C2.5-3
C5: 100u; C2.5-3
GAS: MA03-1
IC1: 7805T; TO220H
ICSP: FE06-1; FE06
LCD_16X2: FE20-1; FE20
LM35: BC547; TO92
NRF24L01+: MA04-2
POT: MA03-1
PWR: PINHD-1X2; 1X02
Q1: 20MHz; QS
R1, R2, R4: 10k; 0207/10
R3: 1k; 0207/10
R5: LDR; 0207/10
S1: 5501
T1: BC547; TO92
U$1: PIC18F4550; PDIP-40

Connections:
GND: 3.3VOUT.2, 5V-3.3V.2, C1.2, C2.2, C3.1, C4.1, C5.1, C6.1, C7.1, GAS.3, IC1.2 (GND), ICSP.3, LCD_16X2.1, LCD_16X2.16, LM35.1 (E), NRF24L01+.1, POT.1, PWR.2, R2.2, R5.2, T1.1 (E), U$1.12 (VSS), U$1.31 (VSS2)
unnamed: R1.2, S1.NO
unnamed: ICSP.1, S1.1A, U$1.1 (MCLR/VPP/RE3)
unnamed: C2.1, Q1.2, U$1.13 (OSC1/CLKI)
unnamed: C1.1, Q1.1, U$1.14 (OSC2/CLKO/RA6)
unnamed: LCD_16X2.7, U$1.19 (RD0/SPP0)
unnamed: LCD_16X2.8, U$1.20 (RD1/SPP1)
unnamed: LCD_16X2.9, U$1.21 (RD2/SPP2)
unnamed: LCD_16X2.10, U$1.22 (RD3/SPP3)
unnamed: LCD_16X2.11, U$1.27 (RD4/SPP4)
unnamed: LCD_16X2.12, U$1.28 (RD5/SPP5/P1B)
unnamed: LCD_16X2.13, U$1.29 (RD6/SPP6/P1C)
unnamed: LCD_16X2.14, U$1.30 (RD7/SPP7/P1D)
unnamed: ICSP.4, U$1.40 (RB7/KBI3/PGD)
unnamed: LCD_16X2.5, R2.1
unnamed: LCD_16X2.6, U$1.16 (RC1/T1OSI/CCP2/UOE)
unnamed: LCD_16X2.4, U$1.17 (RC2/CCP1/P1A)
unnamed: BUZZER.2, T1.3 (C)
unnamed: NRF24L01+.5, U$1.34 (RB1/AN10/INT1/SCK/SCL)
unnamed: NRF24L01+.7, U$1.33 (RB0/AN12/INT0/FLT0/SDI/SDA)
unnamed: NRF24L01+.6, U$1.26 (RC7/RX/DT/SDO)
unnamed: NRF24L01+.8, U$1.35 (RB2/AN8/INT2/VMO)
unnamed: NRF24L01+.4, U$1.37 (RB4/AN11/KBIO/CSSPP)
unnamed: NRF24L01+.3, U$1.36 (RB3/AN9/CCP2/VPO)
unnamed: GAS.2, U$1.4 (RA2/AN2/VREF-/CVREF)
unnamed: R3.1, T1.2 (B)
unnamed: R3.2, U$1.15 (RC0/T1OSO/T13CKI)
unnamed: R4.2, R5.1, U$1.2 (RA0/AN0)
unnamed: LM35.2 (B), U$1.3 (RA1/AN1)
VCC: 3.3VOUT.1, 5V-3.3V.1, BUZZER.1, C3.2, C4.2, C6.2, C7.2, GAS.1, IC1.3 (VO), ICSP.2, LCD_16X2.2, LCD_16X2.15, LM35.3 (C), NRF24L01+.2, R1.1, R4.1, U$1.11 (VDD), U$1.32 (VDD2)
VDD: C5.2, IC1.1 (VI), PWR.1

Notes on the sheet:
12V
