UdayanSinha/Home_Automation_System/Schematics/HAS_Door_Control.sch

## EAGLE design Schematics/HAS_Door_Control.sch (2016-03-23)

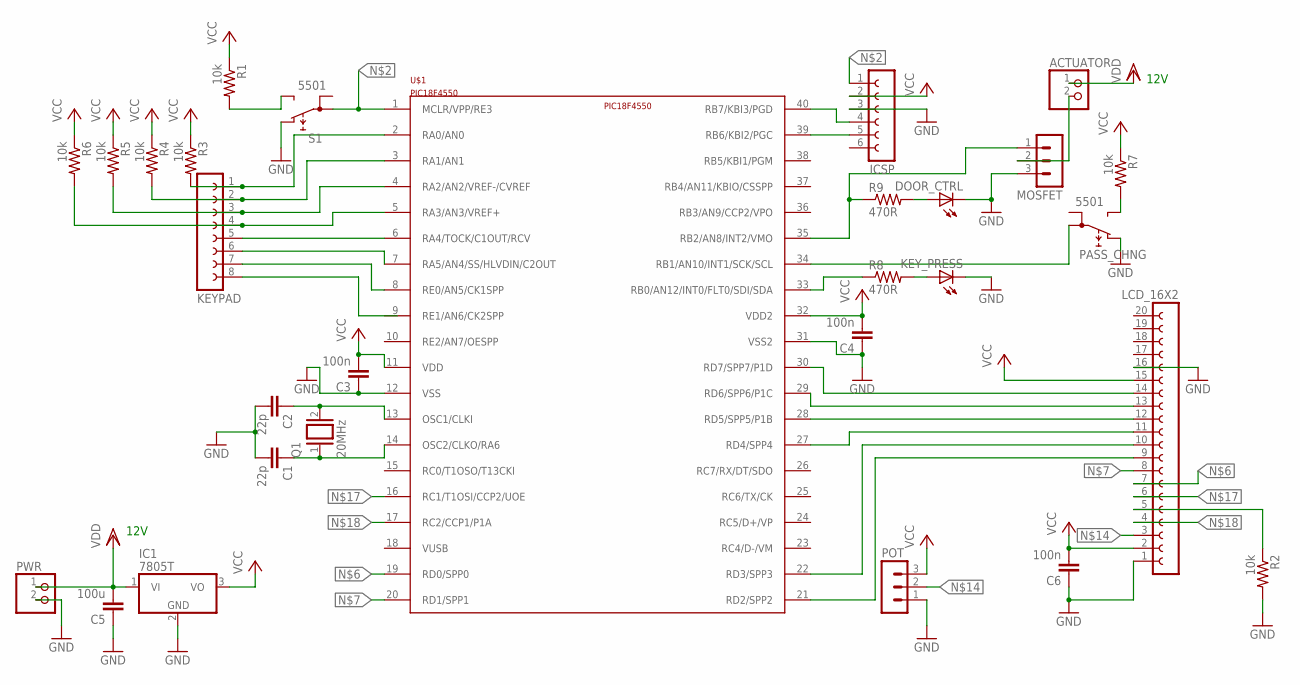
[picture p33: schematic HAS_Door_Control.sch]

Parts:
ACTUATOR: PINHD-1X2; 1X02
C1, C2: 22p; C2.5-3
C3, C4, C6: 100n; C2.5-3
C5: 100u; C2.5-3
DOOR_CTRL: LED_ELD260; LED_LD260
IC1: 7805T; TO220H
ICSP: FE06-1; FE06
KEYPAD: FE08-1; FE08
KEY_PRESS: LED_ELD260; LED_LD260
LCD_16X2: FE20-1; FE20
MOSFET: MA03-1
PASS_CHNG: 5501
POT: MA03-1
PWR: PINHD-1X2; 1X02
Q1: 20MHz; QS
R1, R2, R3, R4, R5, R6, R7: 10k; 0207/10
R8, R9: 470R; 0207/10
S1: 5501
U$1: PIC18F4550; PDIP-40

Connections:
GND: C1.2, C2.2, C3.1, C4.1, C5.1, C6.1, DOOR_CTRL.K (C), IC1.2 (GND), ICSP.3, KEY_PRESS.K (C), LCD_16X2.1, LCD_16X2.16, MOSFET.3, PASS_CHNG.NC, POT.1, PWR.2, R2.2, S1.NC, U$1.12 (VSS), U$1.31 (VSS2)
unnamed: R1.2, S1.NO
unnamed: ICSP.1, S1.1A, U$1.1 (MCLR/VPP/RE3)
unnamed: C2.1, Q1.2, U$1.13 (OSC1/CLKI)
unnamed: KEYPAD.5, U$1.6 (RA4/TOCK/C1OUT/RCV)
unnamed: DOOR_CTRL.A, R9.2
unnamed: LCD_16X2.7, U$1.19 (RD0/SPP0)
unnamed: LCD_16X2.8, U$1.20 (RD1/SPP1)
unnamed: LCD_16X2.9, U$1.21 (RD2/SPP2)
unnamed: LCD_16X2.10, U$1.22 (RD3/SPP3)
unnamed: LCD_16X2.11, U$1.27 (RD4/SPP4)
unnamed: LCD_16X2.12, U$1.28 (RD5/SPP5/P1B)
unnamed: LCD_16X2.13, U$1.29 (RD6/SPP6/P1C)
unnamed: LCD_16X2.14, U$1.30 (RD7/SPP7/P1D)
unnamed: LCD_16X2.3, POT.2
unnamed: LCD_16X2.5, R2.1
unnamed: ICSP.4, U$1.40 (RB7/KBI3/PGD)
unnamed: LCD_16X2.6, U$1.16 (RC1/T1OSI/CCP2/UOE)
unnamed: LCD_16X2.4, U$1.17 (RC2/CCP1/P1A)
unnamed: ICSP.5, U$1.39 (RB6/KBI2/PGC)
unnamed: KEYPAD.1, R3.2, U$1.2 (RA0/AN0)
unnamed: KEYPAD.2, R4.2, U$1.3 (RA1/AN1)
unnamed: KEYPAD.3, R5.2, U$1.4 (RA2/AN2/VREF-/CVREF)
unnamed: KEYPAD.4, R6.2, U$1.5 (RA3/AN3/VREF+)
unnamed: KEYPAD.6, U$1.7 (RA5/AN4/SS/HLVDIN/C2OUT)
unnamed: KEYPAD.7, U$1.8 (RE0/AN5/CK1SPP)
unnamed: KEY_PRESS.A, R8.2
unnamed: PASS_CHNG.1A, U$1.34 (RB1/AN10/INT1/SCK/SCL)
unnamed: R8.1, U$1.33 (RB0/AN12/INT0/FLT0/SDI/SDA)
unnamed: PASS_CHNG.NO, R7.2
unnamed: MOSFET.1, R9.1, U$1.35 (RB2/AN8/INT2/VMO)
unnamed: C1.1, Q1.1, U$1.14 (OSC2/CLKO/RA6)
unnamed: ACTUATOR.2, MOSFET.2
VCC: C3.2, C4.2, C6.2, IC1.3 (VO), ICSP.2, LCD_16X2.2, LCD_16X2.15, POT.3, R1.1, R3.1, R4.1, R5.1, R6.1, R7.1, U$1.11 (VDD), U$1.32 (VDD2)
VDD: ACTUATOR.1, C5.2, IC1.1 (VI), PWR.1

Notes on the sheet:
12V
