UdayanSinha/Home_Automation_System/Schematics/HAS_Relay_Module.sch

## EAGLE design Schematics/HAS_Relay_Module.sch (2016-03-23)

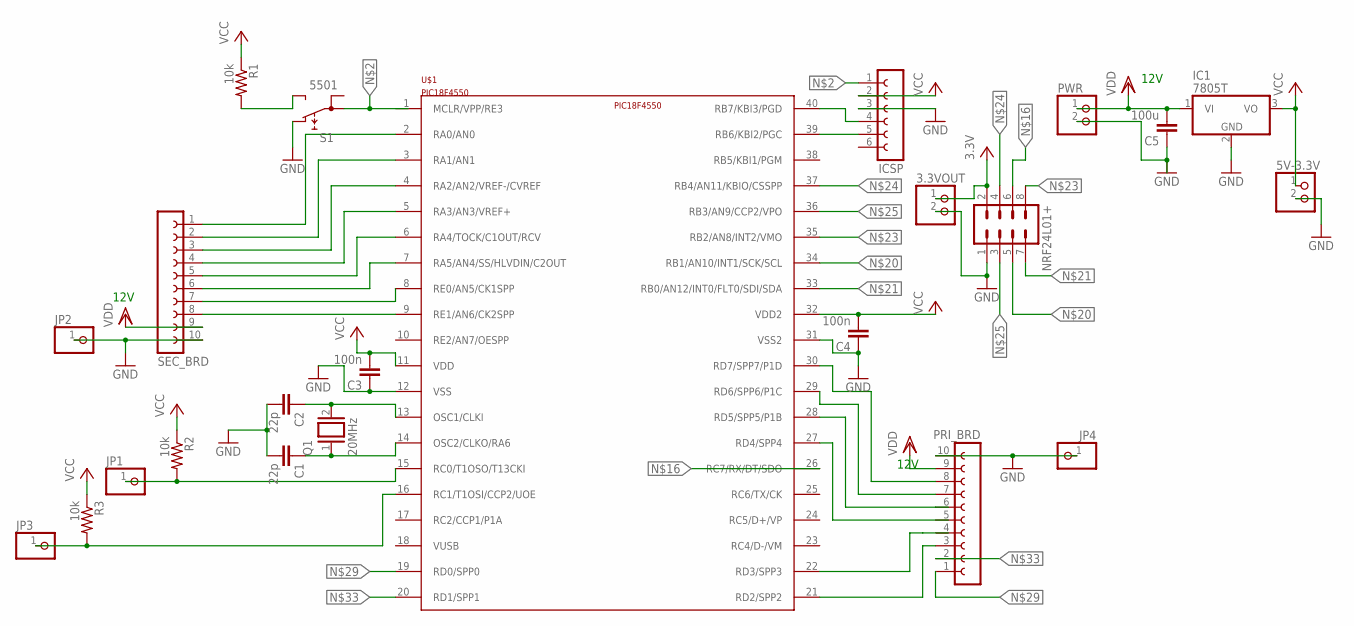
[picture p34: schematic HAS_Relay_Module.sch]

Parts:
3.3VOUT, 5V-3.3V: PINHD-1X2; 1X02
C1, C2: 22p; C2.5-3
C3, C4: 100n; C2.5-3
C5: 100u; C2.5-3
IC1: 7805T; TO220H
ICSP: FE06-1; FE06
JP1, JP2, JP3, JP4: PINHD-1X1; 1X01
NRF24L01+: MA04-2
PRI_BRD: FE10-1; FE10
PWR: PINHD-1X2; 1X02
Q1: 20MHz; QS
R1, R2, R3: 10k; 0207/10
S1: 5501
SEC_BRD: FE10-1; FE10
U$1: PIC18F4550; PDIP-40

Connections:
GND: 3.3VOUT.2, 5V-3.3V.2, C1.2, C2.2, C3.1, C4.1, IC1.2 (GND), ICSP.3, JP2.1, JP4.1, NRF24L01+.1, PRI_BRD.10, S1.NC, SEC_BRD.10, U$1.12 (VSS), U$1.31 (VSS2)
unnamed: R1.2, S1.NO
unnamed: ICSP.1, S1.1A
unnamed: C2.1, Q1.2, U$1.13 (OSC1/CLKI)
unnamed: C1.1, Q1.1, U$1.14 (OSC2/CLKO/RA6)
unnamed: JP1.1, R2.2, U$1.15 (RC0/T1OSO/T13CKI)
unnamed: PRI_BRD.3, U$1.21 (RD2/SPP2)
unnamed: PRI_BRD.7, U$1.29 (RD6/SPP6/P1C)
unnamed: PRI_BRD.8, U$1.30 (RD7/SPP7/P1D)
unnamed: SEC_BRD.1, U$1.2 (RA0/AN0)
unnamed: SEC_BRD.2, U$1.3 (RA1/AN1)
unnamed: NRF24L01+.6, U$1.26 (RC7/RX/DT/SDO)
unnamed: SEC_BRD.3, U$1.4 (RA2/AN2/VREF-/CVREF)
unnamed: SEC_BRD.4, U$1.5 (RA3/AN3/VREF+)
unnamed: ICSP.4, U$1.40 (RB7/KBI3/PGD)
unnamed: NRF24L01+.5, U$1.34 (RB1/AN10/INT1/SCK/SCL)
unnamed: NRF24L01+.7, U$1.33 (RB0/AN12/INT0/FLT0/SDI/SDA)
unnamed: NRF24L01+.8, U$1.35 (RB2/AN8/INT2/VMO)
unnamed: NRF24L01+.4, U$1.37 (RB4/AN11/KBIO/CSSPP)
unnamed: NRF24L01+.3, U$1.36 (RB3/AN9/CCP2/VPO)
unnamed: SEC_BRD.5, U$1.6 (RA4/TOCK/C1OUT/RCV)
unnamed: SEC_BRD.6, U$1.7 (RA5/AN4/SS/HLVDIN/C2OUT)
unnamed: SEC_BRD.7, U$1.8 (RE0/AN5/CK1SPP)
unnamed: PRI_BRD.1, U$1.19 (RD0/SPP0)
unnamed: JP3.1, R3.2, U$1.16 (RC1/T1OSI/CCP2/UOE)
unnamed: SEC_BRD.8, U$1.9 (RE1/AN6/CK2SPP)
unnamed: PRI_BRD.2, U$1.20 (RD1/SPP1)
unnamed: ICSP.5, U$1.39 (RB6/KBI2/PGC)
unnamed: C5.1, PWR.2
VCC: 3.3VOUT.1, 5V-3.3V.1, C3.2, C4.2, IC1.3 (VO), ICSP.2, NRF24L01+.2, R1.1, R2.1, R3.1, U$1.11 (VDD), U$1.32 (VDD2)
VDD: C5.2, IC1.1 (VI), PRI_BRD.9, PWR.1, SEC_BRD.9

Notes on the sheet:
12V
